twelve168/RandomPlay-Mroning/docs/hello.md

# Hello, RandomPlay-Mroning

这是一份最最基础的笔记，用来演示项目结构。

- 任何 `.md` 都会被 Git 当作文本追踪。
- 行尾换行符请保持 LF 或 CRLF 一致，避免噪音 diff。
- 想忽略某些文件，请在根目录的 `.gitignore` 里加规则。
