twelve168/RandomPlay-Mroning/images/3f81583922b20b74d60b699e1923a110_720.jpg

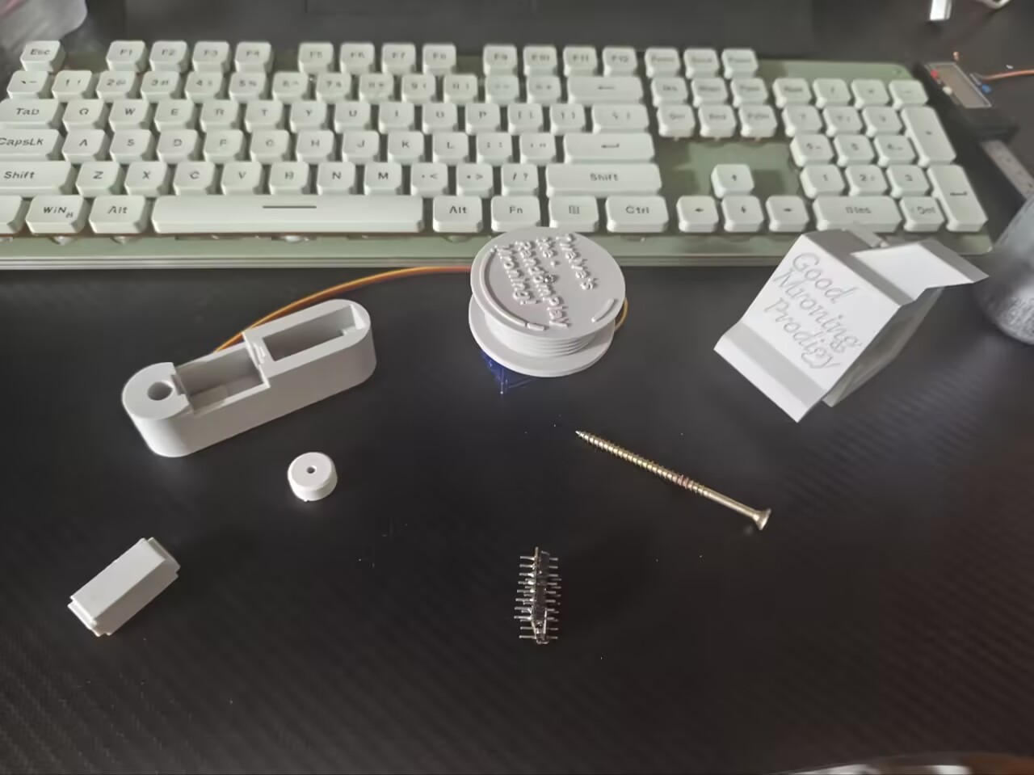
images/3f81583922b20b74d60b699e1923a110_720.jpg
