twelve168/RandomPlay-Mroning/images/893e3b519165873c25429b14ad0f976a_720.jpg

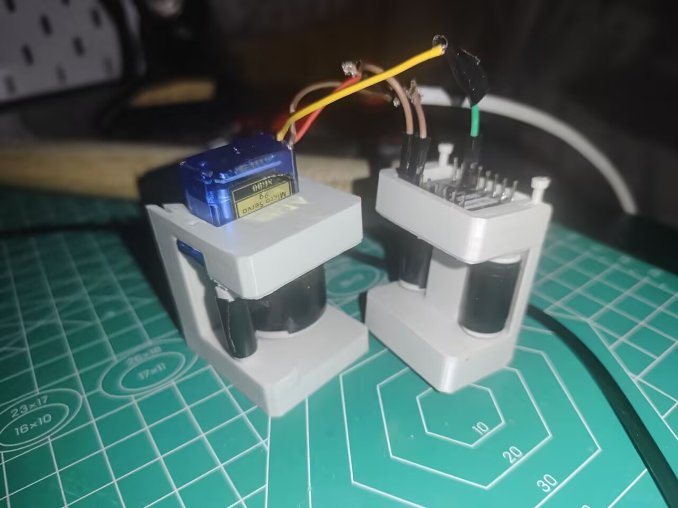
images/893e3b519165873c25429b14ad0f976a_720.jpg
