twelve168/RandomPlay-Mroning/images/debf3f82c5bbcd7815cef242de838e63_720.jpg

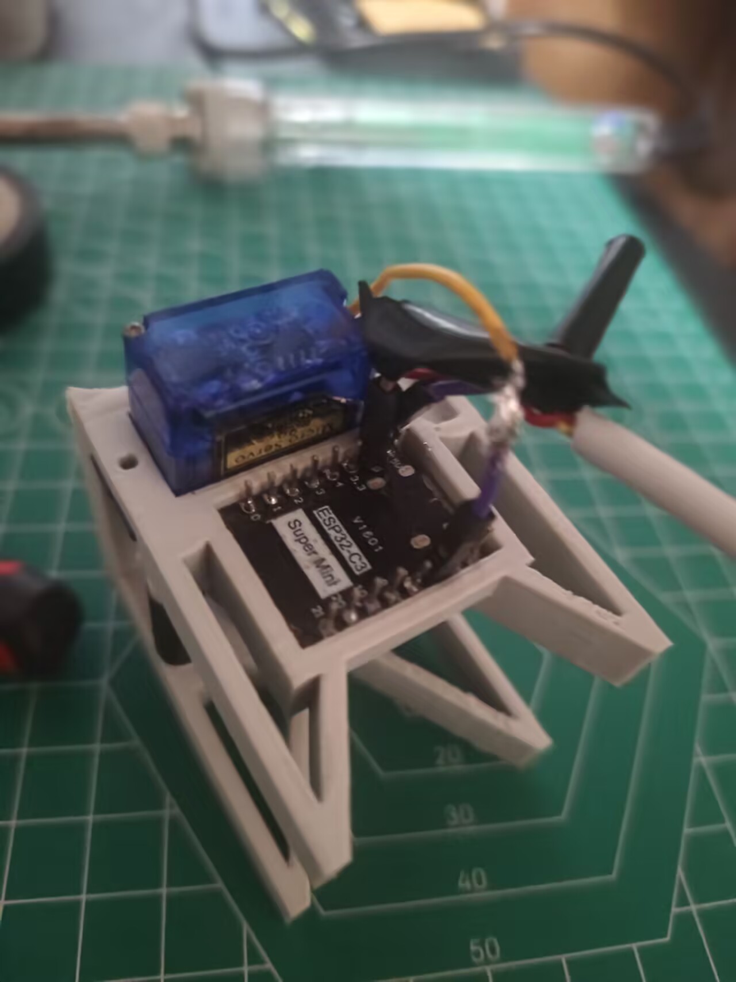
images/debf3f82c5bbcd7815cef242de838e63_720.jpg
