twelve168/RandomPlay-Mroning/images/e5531f9b781018b7c2be051e63ec857e_720.jpg

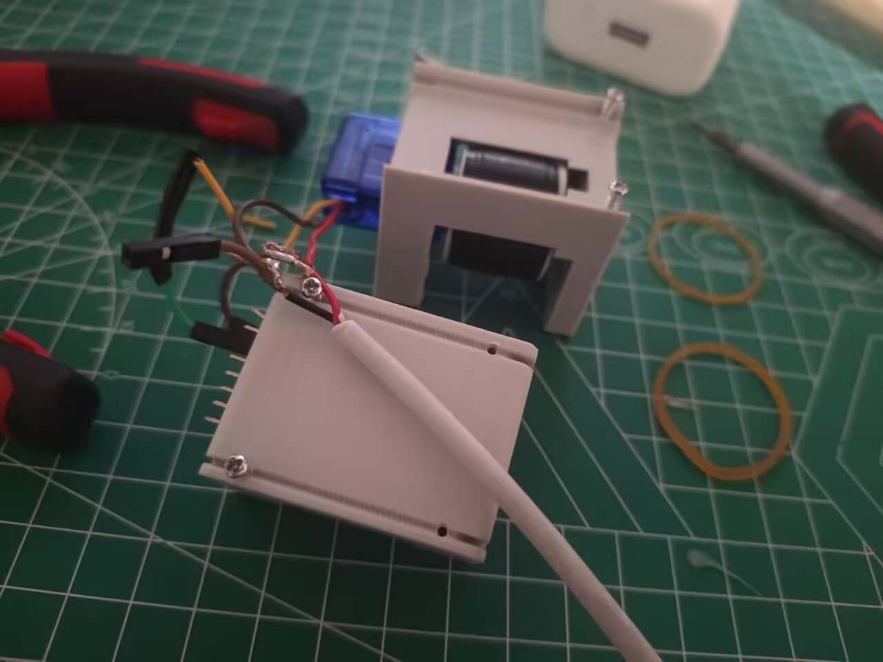
images/e5531f9b781018b7c2be051e63ec857e_720.jpg
