twelve168/RandomPlay-Mroning/images/f7f35edc88bc4a12efcbb2a83b7e5bbf_720.jpg

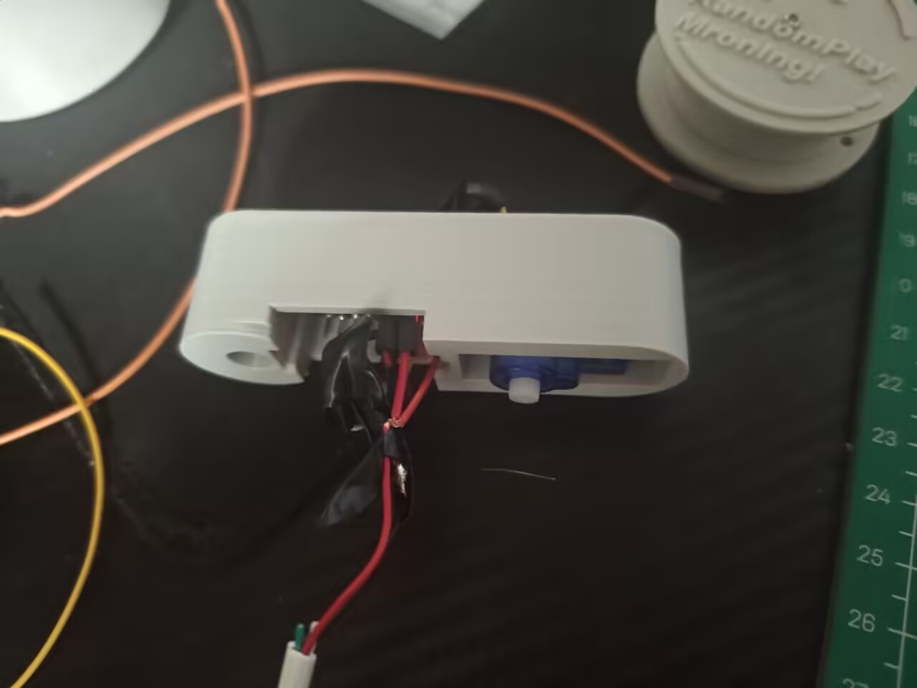
images/f7f35edc88bc4a12efcbb2a83b7e5bbf_720.jpg
