twelve168/RandomPlay-Mroning/docs/bom.md

# 物料清单 (BOM)

整机成本约 **￥15**（研发损耗另计，全程总计约 ￥40）。

| # | 物料 | 规格 | 数量 | 参考单价 | 备注 |
|---|---|---|---|---|---|
| 1 | ESP32-C3 Super Mini 开发板 | 4 MB flash, Type-C | 1 | ~￥9 | BLE 5.0 + Wi-Fi 双固件方案 |
| 2 | SG90 舵机 | **360° 连续旋转版** | 1 | ~￥5 | ⚠️ 切勿买成 180° 位置版 |
| 3 | 3D 打印结构件 | v5.2（见 [cad/](../cad/)） | 1 套 | ~￥1 | PLA/PETG 均可 |
| 4 | M2 螺丝 | 20 mm | 2 | 忽略成本 | 靠结构本身不用螺丝也能固定的比较稳，螺丝为非必要项 |
| 5 | 杜邦线 | 母对母 3 Pin | 3 | 忽略成本 | 购买SG90时通常有赠送 |
| 6 | 配重物 | 矿泉水等 | 1 | 忽略成本 | 挂载增加轮面压力 |
| 7 | 遮光胶带 / 深色耗材 | 可选 | — | — | 遮挡板载电源 LED |

> 供电：直接使用 ESP32 的 Type-C 口（5V），无需额外接线。

## 关键选型说明

- **为什么是 360° 舵机？** 窗帘开合是连续行程而非定点角度，180° 位置舵机无法持续
  旋转输出行程。
- **为什么自带配重？** 结构件直接悬挂在轨道上，靠配重把主动轮压紧轨道以获得
  足够切向摩擦力（v4~v5 迭代的核心结论）。
- **为什么主动轮直径偏小？** 同等舵机扭矩下小直径轮的切向力更大，避免推帘
  吃力与堵转烧电机（v5.1 的关键改进）。
