twelve168/RandomPlay-Mroning/RandomPlay-Mroning v5.2 260904.step

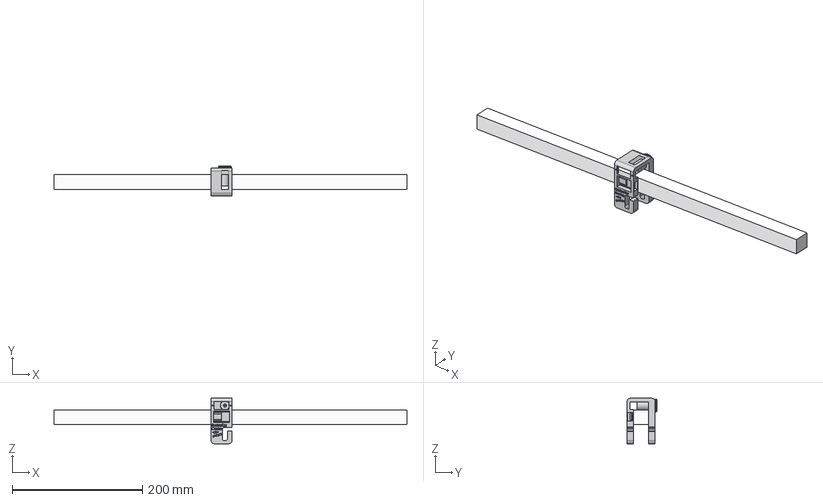
[picture p9: CAD file, 2026-09-04]
RandomPlay-Mroning v5.2 260904.step
543.0 x 46.1 x 70.0 mm
