twelve168/RandomPlay-Mroning/(list of files, cad)

Other CAD files:
RandomPlay-Mroning v5.2 260904.f3d
