twelve168/RandomPlay-Mroning/(commit log)

2026-09-04 RandomPlay-Mroning自动窗帘机项目
2026-09-04 docs: 补充项目背景,标题改为「￥17低成本自动窗帘机项目」
2026-09-05 docs: 添加 MIT 许可证, 完善 README 排版与措辞
2026-09-05 docs: ESPHome 版本补充 scheduler-card 定时任务插件建议
2026-11-05 refactor: 工程规范化重构 — 目录重排、固件规范化、文档体系与 CI
    - 重排仓库结构: firmware/{arduino,esphome}, cad, docs, images;
    CAD 文件改为无空格规范命名 (git mv 保留历史)
    - ESPHome: 新增 substitutions 集中调参; 修正拼写(swith->switch)、
    状态文案与实际时长不一致、frequency 写法; 补 board 字段
    (修复新版 ESPHome config 校验失败); 拆分 api_key/ota_password;
    提供 secrets.example.yaml 模板
    - Arduino 固件: 补文件头与协议文档引用, 魔法数抽为具名常量,
    指令解析增加格式错误日志
    - 新增 docs: bom / assembly / ble-protocol / design-history
    - README 重写为专业开源布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
2026-11-05 docs: BOM 调整螺丝/杜邦线为忽略成本并更新备注
    - M2 螺丝: 忽略成本, 备注结构本身免螺丝固定已足够稳, 非必要项
    - 杜邦线: 忽略成本, 备注购买 SG90 时通常有赠送
    - README: 去除中英文之间不必要的空格
2026-11-08 docs: BOM 成本口径调整为 ￥15, README 收尾调整
    - BOM: 3D 打印件 ~￥1, 配重物忽略成本, 整机成本 ￥15
    (README 中三处 ￥17 同步改为 ￥15)
    - README: Roadmap 去掉预计开源的具体项目列表
    - README: 末尾追加版本标记 v5.2 261108
2026-11-08 docs: 同步 CHANGELOG v5.2 日期为 2026-11-08
    与 README 末尾版本标记 (v5.2 261108) 保持一致
2026-11-08 docs: 措辞微调, 迭代史移除后续规划表
    - README: 简介措辞调整, Roadmap 指向个人主页查看系列其它项目
    - design-history: 移除后续规划章节, 删除接线端子经验条目
2026-11-08 docs: README 添加作者联系方式
